DavidJRichards/ESC_Inverter_400Hz/images/IMG_20220419_092551.jpg

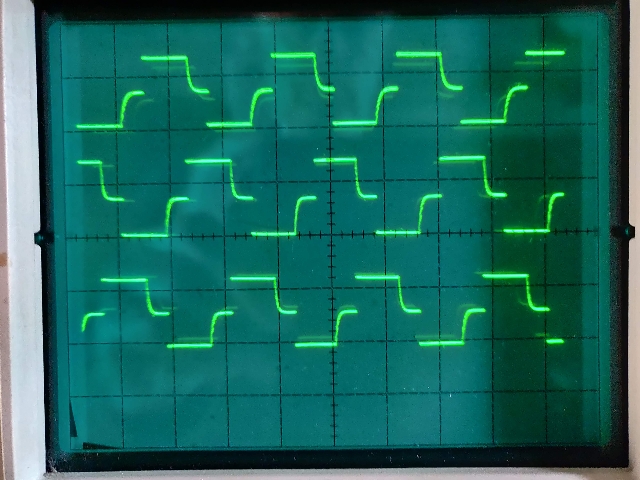
images/IMG_20220419_092551.jpg
