DavidJRichards/ESC_Inverter_400Hz/images/IMG_20220419_092617.jpg

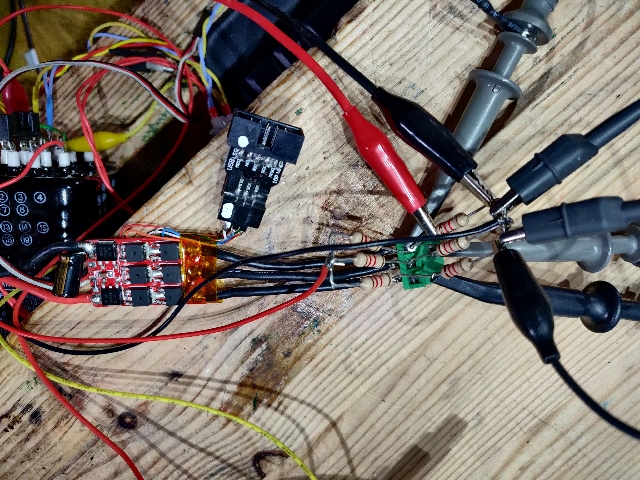
images/IMG_20220419_092617.jpg
