DavidJRichards/ESC_Inverter_400Hz/images/IMG_20220419_124343.jpg

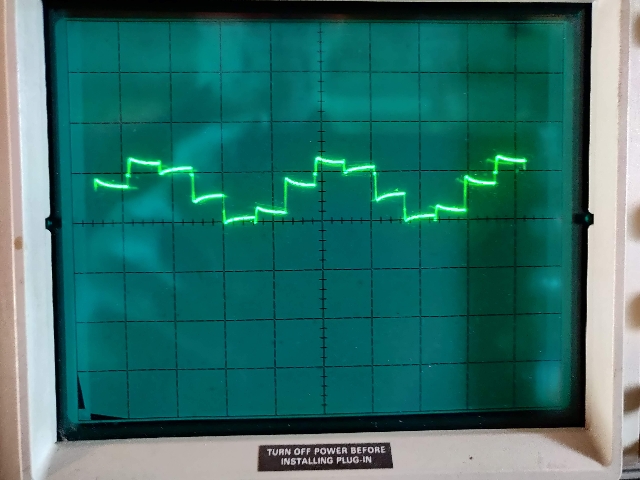
images/IMG_20220419_124343.jpg
