DavidJRichards/ESC_Inverter_400Hz/images/IMG_20220419_183346.jpg

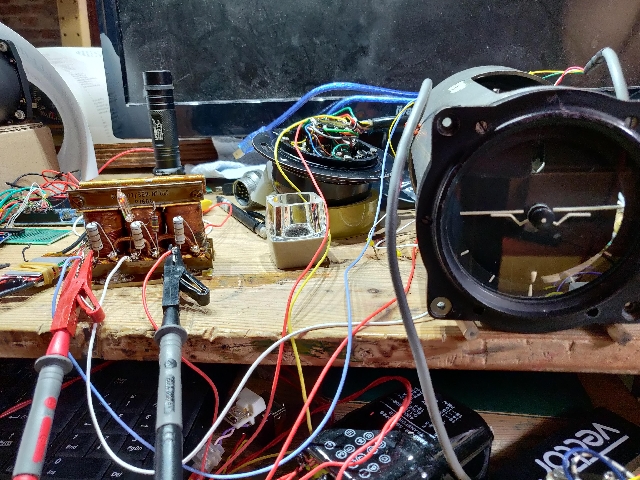
images/IMG_20220419_183346.jpg
