DavidJRichards/ESC_Inverter_400Hz/images/IMG_20220420_142937.jpg

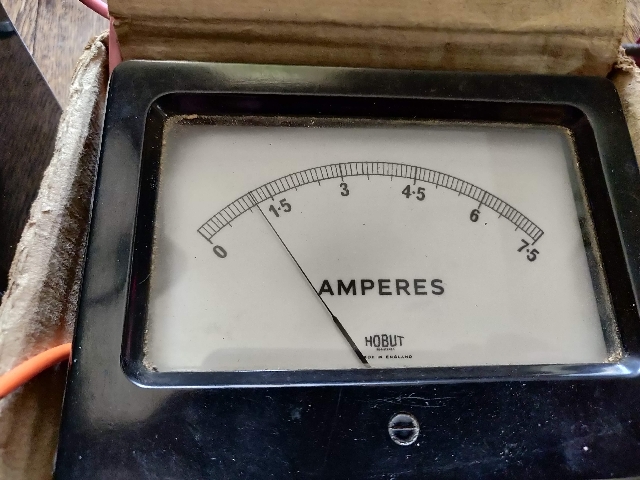
images/IMG_20220420_142937.jpg
