DavidJRichards/ESC_Inverter_400Hz/images/IMG_20220421_102720.jpg

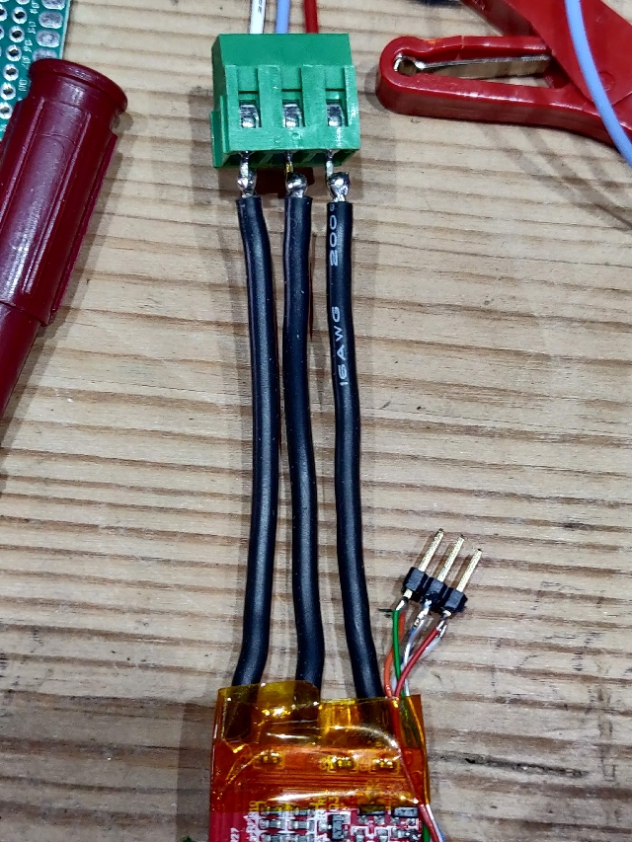
images/IMG_20220421_102720.jpg
