DavidJRichards/ESC_Inverter_400Hz/(commit log)

2022-04-20 Simplified software
    Redundant code removed
    Added voltage waveform oscilloscope photos
    Frequency closer, now 400.3 Hz
    Added chip reference documents
2022-04-23 added alternative tp ESC firmware
